amalzewita/Production-Line/README.md

# Project Information

- Project: `[Production Line for Product Sorting]`
- Authors: `[Amal Amr]`, `[Marawan Ashry]`, `[Malak Tarek]`
- Videos: [Link](https://drive.google.com/drive/u/0/folders/1szjnrMlwpyWx0n-irzwF31AYm2X0MozQ)

## Feedback & Contributions

Feedback is essential for the growth and improvement of this project. Please raise an issue in this repository for any bugs, suggestions, or improvements. Contributions via pull requests are also welcome!

## IMPORTANT NOTE
  A comprehensive PDF named `[Report]` detailing all pertinent information regarding the project is available.
