amalzewita/Production-Line/Report.pdf

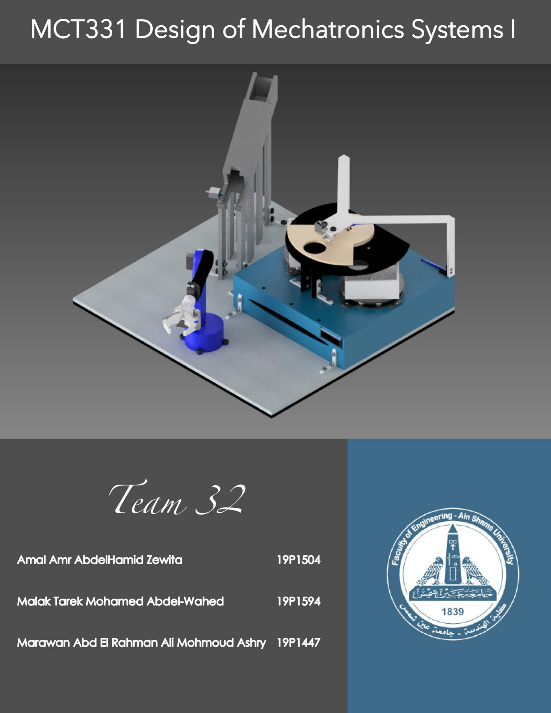
[picture p1: page 1]

1

AIN SHAMS UNIVERSITY
I-Credit Hours Engineering Programs (i.CHEP)
2 | Page

Contents

I-Credit Hours Engineering Programs (i.CHEP)

3 | Page

Table of figures

I-Credit Hours Engineering Programs (i.CHEP)

4 | Page

## ABSTRACT

A production line is a collection of coordinated procedures set up in a factory where parts are joined together to create finished goods or where raw materials are processed to create finished goods fit for consumption.
Usually, in order to make raw materials functional, such as metal ores, agricultural products like foodstuffs, or textile source plants like cotton and flax, a series of treatments is needed. The procedures for metal include crushing, smelting, and more refinement. For plants, the valuable material needs to be removed from the husks or other impurities before being processed for sale. In our project, we will design a production line consists of three main stations: Feeding, Sorting and packaging. By the help of a 3-DOF robotic arm which contains motors and sensors, we will be able to do the feeding station so that the robotic arm can take our product from the magazine and put it in the sorting-by material station. By placing the Inductive Proximity Switch- metal sensor, we could successfully sort our products by material by detect if the product is metal or not. In addition, our rotary-designed sorting mechanism will be able to do the packaging process which is the final station in our production line.
A lot of motors, sensors, gears, bearings.. will be used in our unique production lin. So that we will briefly discuss each station by its sensors and electrical and mechanical components and how they will work efficiently. Most common electrical and mechanical components used are:
- Servo motors
- IR sensor
- Inductive proximity sensor
- Arduino UNO
- Thrust Bearings
- L supports

By the end of this project, a well-organized production line will successfully be able to do the main three stations that we have already mentioned above by the help of a robotic arm with three degrees of freedom. So, we will now discus each station and how it works with the aid of the a well-organized and accurate sketches and images of the mechanical design by also showing the electrical parts and the reason for each usage.

I-Credit Hours Engineering Programs (i.CHEP)

5 | Page

## 1.0 INTRODUCTION

We should comprehend the stages involved in creating a mechatronic system on both a micro and macro cycle level for this project, as well as how to incorporate product design criteria like utilizing materials, utilizing a human-machine interface, and using modular components The successful testing of the product in accordance with each station's specifications, as well as the stations' integration and safety features, will all be evaluated.
The Design of Mechatronics Systems standard VDI 2206 must be followed while creating a production line. The manufacturing line's primary function is to handle cylindrical or cuboid-shaped products and sort them according to their shape or substance before packing each sorted product category into its own packaging.
So, Our project is a production line that consists of THREE main stations: Feeding, Sorting and packaging. By the aid of motors and sensors, we will be able to do the feeding station so that the robotic arm can take our product from the magazine and put it in the rotary sorting-by material station.
Multiple programs or threads can run simultaneously on the majority of operating systems. This is referred to as multitasking. At any given time, each processor core can only have one program running on it. The scheduler, a component of the operating system, selects which program to run at what time and creates the appearance of simultaneous operation by swiftly switching between each program.
A Real Time Operating System (RTOSscheduler )'s is created to offer a predictable (often referred to as deterministic) pattern of execution. Given that embedded systems, like the Arduino devices, frequently have real-time requirements, this is especially intriguing for embedded systems.

I-Credit Hours Engineering Programs (i.CHEP)

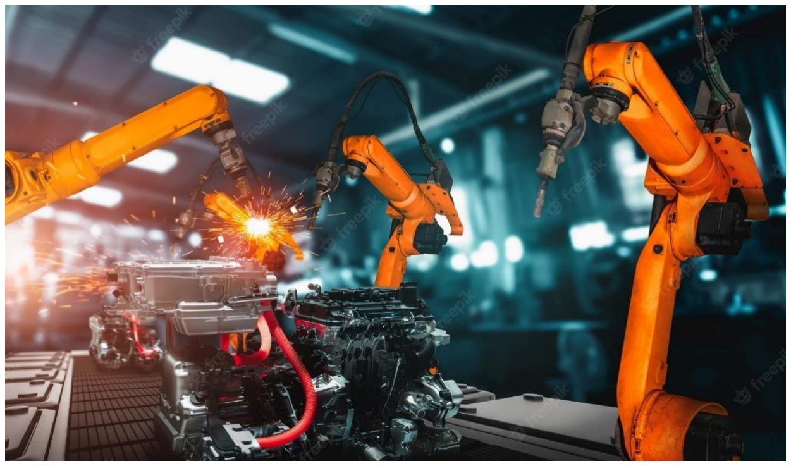
[picture p2: figure]

6 | Page

Traditional real-time schedulers, like the one included in FreeRTOS, accomplish determinism by letting the user give each execution thread a priority. The priority is then used by the scheduler to decide which thread of execution should be executed next. So, our software will be done by RTOS.

Figure 1:Production line

I-Credit Hours Engineering Programs (i.CHEP)

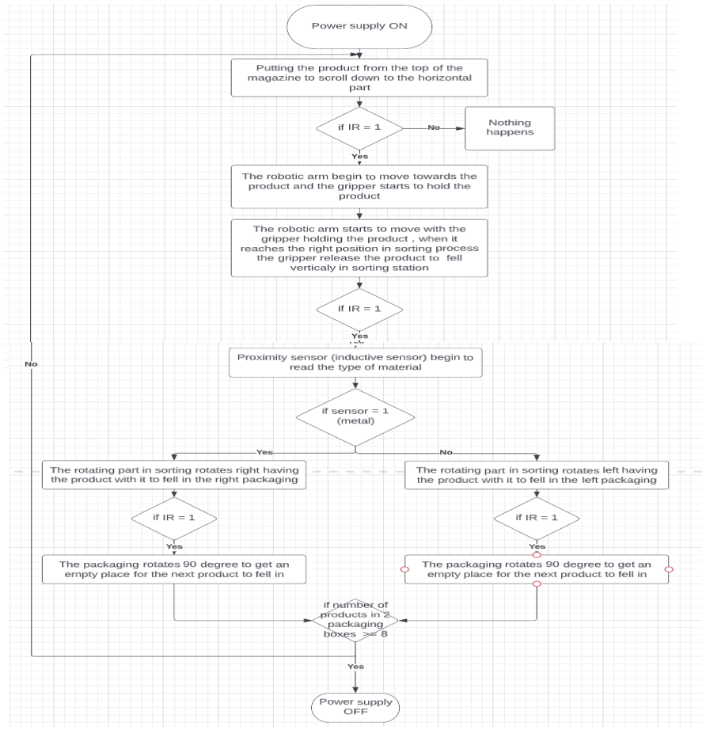
[picture p3: figure]

7 | Page

## 2.0 PRODUCT JOURNEY

Figure 2:Product journey flow chart

I-Credit Hours Engineering Programs (i.CHEP)

8 | Page

## 3.0 FEEDING STATION

### 3.1 Mechanical System

The magazine is our pure mechanical feeding station, It is an inclined box so that our cylindrical product will be able to roll over until the product is stop by a vertical surface and it is also our feeding station. Having an Infra-Red sensor at the end, this allows the robotic arm to pick the product through the opened-front legs and move it the sorting station. The magazine has three legs on each side which are fixed by grooves in both sides with the magazine and also the base. For more fixation, we added 4 L-supports using M8 bolts and nuts , 2 in each side to surely fix the magazine in base. Material: Wooden. Our magazine will be manufactured by a laser cutting machine. But the final part that stops the products will be made by 3D printing.
The IR sensor is placed at the end of the magazine which the horizontal part that the product will stay at until the robotic arm comes and grips it. A wooden box is designed by a laser cutting machine to cover the IR sensor. A M3 bolt is used to fix the IR sensor in the box and the box itself to the magazine.

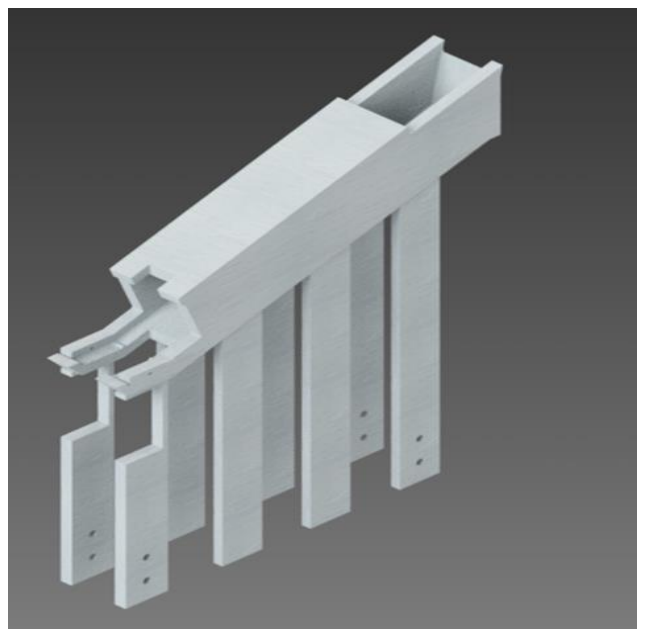
[picture p4: figure]

Figure 3:Feeding Station

I-Credit Hours Engineering Programs (i.CHEP)

9 | Page

## 4.0 SORTING STATION

### 4.1 Mechanical System

Our sorting-by material station is made of two plates and a thrust bearing. When the robotic arm takes the product from the magazine and then puts it into the sorting top plate hole, the proximity sensor reads the product’s material. Then, the plate moves either right or left by the help of a servo motor to drop the product into the packaging boxes via a hole in bottom plate. Due to the high weight on the sorting shaft, we add a thrust bearing to carry the axial load. We designed our thrust bearing to have a large diameter to support the top plate. We fixed the bottom thrust bearing plate into the bottom sorting plate with 4 M4 bolts. The supports that hold the fixed sorting plate are fixed by grooves in electrical box and L supports. Also, fixed with grooves and L supports also from the upper side with the fixed part of sorting and bolts from top and bottom. Material: Wooden. Our two plates of sorting mechanism were manufactured by a laser cutting machine.

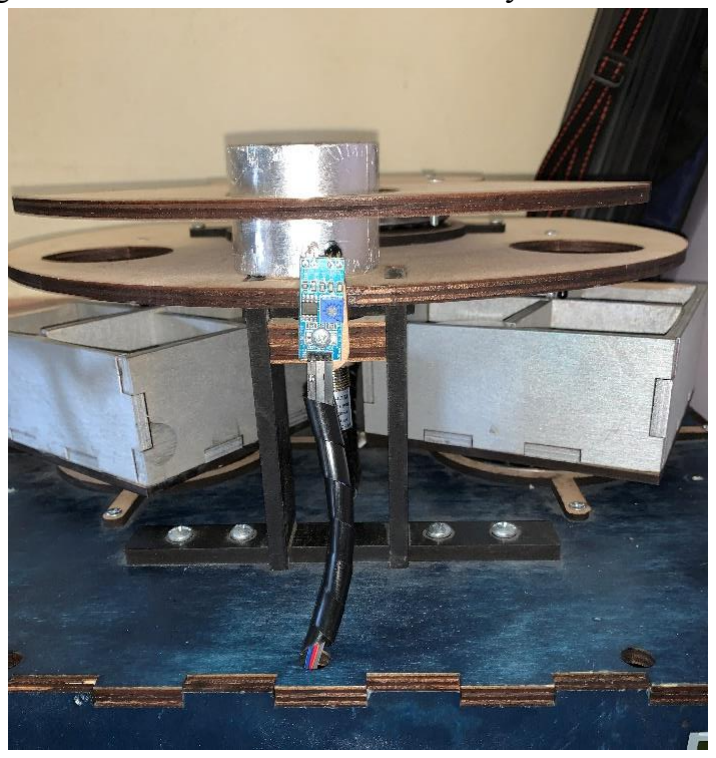
[picture p5: figure]

Figure 4: Sorting station

I-Credit Hours Engineering Programs (i.CHEP)

10 | Page

### 4.2 Actuator Sizing

Formula Sheet for motor

Tmotor = TR + Jtotalθ̈

Jtotal = 2 JL (effictive) + Jb (effictive) + Jp (effictive)
Where;
Jtotal total inertia,

JL (effictive) inertia load,

Jb (effictive) inertia belt,

Jp (effictive) inertia pully.

TR = TLoad + TFriction + TDamping
Where;
TR resisting torque
TLoad load torque,

TFriction friction torque,

TDamping damping torque.

Assuming TFriction = 0 / TDamping = 0

Jtotal = 2 JL (effictive) + Jb (effictive) + Jp (effictive)
mL = 0.227 kg / rp = 0.1775 m

JL (effictive) = 0.5mL(rp)

2
η | = 0.5 × 0.227 × (0.1775)²
1 | = 3.6 × 10⁻³kg. m²

Jtotal = 2(JL (effictive))

Jtotal = 7.15 × 10⁻³kg. m²

TR = TLoad
mL = 0.227 kg / rp = 0.1775 m

I-Credit Hours Engineering Programs (i.CHEP)

11 | Page

TLoad = FL rp

η = mL × g × rp
η = 0.227 × 9.81 × 0.1775
1
TR = 0.395 N. m
Assuming ta = 0.3 sec

θ = Π/4 rad

θ̈= ∂θ̇
∂t =

5Π
46 − 0
0.3 − 0
θ̈= ±1.138 rad/sec 2

Tmotor = TR + Jtotalθ̈

Assuming ta = td = 0.3 sec / tc = 2 sec
TR = 0.395 N. m/ Jtotal = 7.15 × 10⁻³kg. m²/ θ =̈ ± 1.138 rad/sec 2

Ta = TR + Jtotalθ̈= 0.395 + (1.138 × 7.15 × 10⁻³) = 0.403 N. m

Tc = TR = 0.395 N. m
Td = TR + Jtotalθ̈= 0.395 + (−1.138 × 7.15 × 10⁻³) = 0.386 N. m

Trms = √⁽⁽Ta)² × ta) + ((Tc)² × tc) + ((Td)² × td)

ta + tc + td

Trms = √⁽⁽⁰.403)² × 0.3) + ((0.395)² × 2) + ((0.386)² × 0.3)

2.6

Trms = 0.3949 N. m < Tmin = 0.9 N. m

(used motor rated torque after multiplying by safety factor )

I-Credit Hours Engineering Programs (i.CHEP)

12 | Page

## 5.0 PACKAGING STATION

### 5.1 Mechanical System

Our Packaging Mechanism is designed to be a box divided into 4 pieces that rotates 90° degrees with a servo motor whenever the IR sensor, planted into the electrical box beneath the packaging boxes, reads that there is a product that was dropped from the sorting station just to expose the empty space for the sorting to drop the new product. Each packaging box contains slots for the IR sensor. To fix the load exerted on the servo motor’s shaft, we used a thrust bearing to reduce the axial load on servo motor’s shaft. The servo motor’s shaft is inserted into horn to fix the servo motor into the packaging. The packaging IR sensors are nested in the fixed sorting plate and will be bended to read the products. Material: Wooden. Our packaging boxes will be manufactured by a laser cutting machine. And as every face has fingers so every face will be manufactured and then meshed together to do the box.

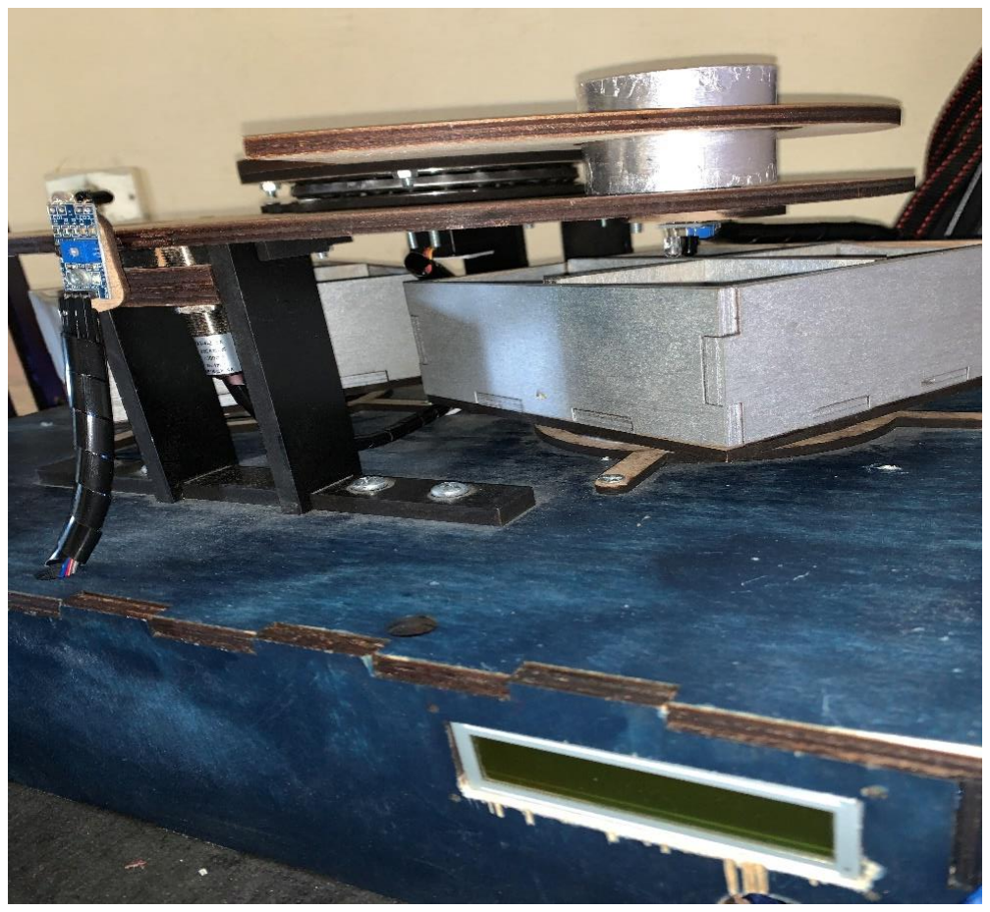
[picture p6: figure]

Figure 5:Packaging station

I-Credit Hours Engineering Programs (i.CHEP)

13 | Page

### 5.2 Actuator Sizing

- Motor of the package of metal products

Jtotal = 2 JL (effictive) + Jb (effictive) + Jp (effictive)
mL = 0.56 kg / rp = 0.0975 m

JL (effictive) = 0.5mL(rp)

2
η | = 0.5 × 0.56 × (0.0975)²
1 | = 2.6 × 10⁻³kg. m²

Jtotal = 2(JL (effictive))

Jtotal = 5.6 × 10⁻³kg. m²

TR = TLoad
mL = 0.56 kg / rp = 0.0975 m

TLoad = FL rp

η = mL × g × rp
η | = 0.56 × 9.81 × 0.0975
| 1
TR = 0.5356 N. m
Assuming ta = 0.3 sec

θ = Π/2 rad

θ̈= ∂θ̇
∂t =

5Π
18 − 0
0.3 − 0
θ̈= ±2.91 rad/sec 2

Tmotor = TR + Jtotalθ̈

Assuming ta = td = 0.3 sec / tc = 1.5 sec
TR = 0.5356 N. m/ Jtotal = 5.2 × 10⁻³kg. m²/ θ =̈ ± 2.91 rad/sec 2

Ta = TR + Jtotalθ̈= 0.5356 + (2.91 × 5.2 × 10⁻³) = 0.55 N. m

Tc = TR = 0.5356 N. m
Td = TR + Jtotalθ̈= 0.395 + (−1.138 × 7.15 × 10⁻³) = 0.52 N. m

I-Credit Hours Engineering Programs (i.CHEP)

14 | Page

Trms = √⁽⁽Ta)² × ta) + ((Tc)² × tc) + ((Td)² × td)

ta + tc + td

Trms = √⁽⁽⁰.55)² × 0.3) + ((0.5356)² × 1.5) + ((0.52)² × 0.3)

2.1

Trms = 0.5356 N. m < Tmin = 0.9 N. m

(used motor rated torque after multiplying by safety factor )

- Motor of the package of nonmetal products

Jtotal = 2 JL (effictive) + Jb (effictive) + Jp (effictive)
mL = 0.375 kg / rp = 0.0975 m

JL (effictive) = 0.5mL(rp)

2
η | = 0.5 × 0.375 × (0.0975)²
1 | = 1.78 × 10⁻³kg. m²

Jtotal = 2(JL (effictive))

Jtotal = 3.565 × 10⁻³kg. m²

TR = TLoad
mL = 0.375 kg / rp = 0.0975 m

TLoad = FL rp

η = mL × g × rp
η | = 0.375 × 9.81 × 0.0975
| 1
TR = 0.359 N. m
Assuming ta = 0.3 sec

θ = Π/2 rad

θ̈= ∂θ̇
∂t =
| 5Π 18 − 0
| 0.3 − 0
θ̈= ±2.91 rad/sec 2

Tmotor = TR + Jtotalθ̈

Assuming ta = td = 0.3 sec / tc = 1.5 sec

I-Credit Hours Engineering Programs (i.CHEP)

15 | Page

TR = 0.359 N. m/ Jtotal = 3.565 × 10⁻³kg. m²/ θ =̈ ± 2.91 rad/sec 2

Ta = TR + Jtotalθ̈= 0.359 + (2.91 × 3.565 × 10⁻³) = 0.364 N. m

Tc = TR = 0.359 N. m
Td = TR + Jtotalθ̈= 0.395 + (−1.138 × 7.15 × 10⁻³) = 0.354 N. m

Trms = √⁽⁽Ta)² × ta) + ((Tc)² × tc) + ((Td)² × td)

ta + tc + td

Trms = √⁽⁽⁰.364)² × 0.3) + ((0.359)² × 1.5) + ((0.354)² × 0.3)

2.1

Trms = 0.359 N. m < Tmin = 0.9 N. m (used motor rated torque after multiplying by safety factor )

I-Credit Hours Engineering Programs (i.CHEP)

16 | Page

## 6.0 ROBOTIC ARM

### 6.1 Mechanical System

Our robotic arm is 3-DOF structure. So, this robotic arm is able to grip the product from the magazine and put it which it will be able to pick the cylinders and move them to the sorting station. Each gear is fixed with a link and the link is fixed with a grip that’s fixed also with the base of the gripper. The grip is designed to be half circled from inside to hold the cylindrical product and make enough contact with its surface. ARM 1: It is a rotating arm connected to the servo motor in the base by a horn fixed with bolts. BASE: It is fixed to the base by 4 M3 bolts and where a servo motor is fixed inside to rotate Arm 1.
GRIPPER: A rotating gripper connected to Arm 2 by a servo motor with horn and bolts.
ARM 2: It is fixed to Arm 1 by a servo motor using a horn
with bolts. It is the initial position and it can rotates 180
degrees.

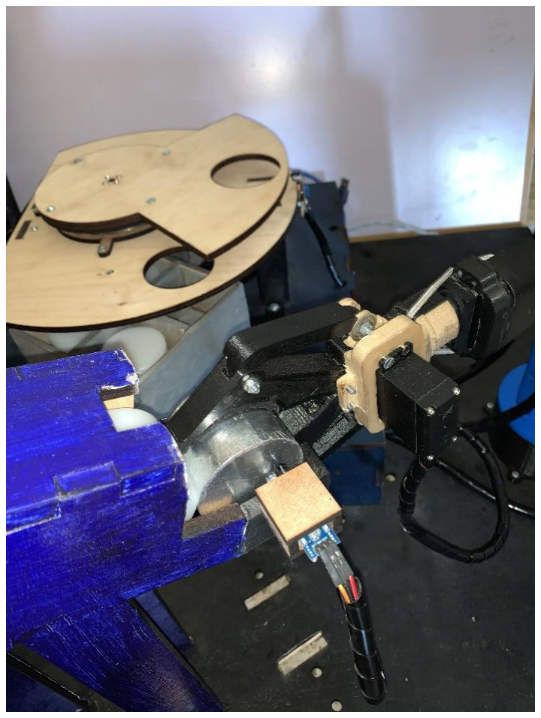
[picture p7: figure]

Material: PLA Our robotic arm will be manufactured by a 3D Printing machine. Figure 6:Robotic arm

I-Credit Hours Engineering Programs (i.CHEP)

17 | Page

### 6.2 Actuator Sizing

- Motor of the base of robotic arm

Jtotal = 2 JL (effictive) + Jb (effictive) + Jp (effictive)
mL = 0.955 kg / rp = 0.05 m

JL (effictive) = 0.5mL(rp)

2
η | = 0.5 × 0.955 × (0.05)²
1 | = 1.19 × 10⁻³ kg. m²

Jtotal = 2(1.19 × 10⁻³)

Jtotal = 2.38 × 10⁻³kg. m²

TR = TLoad
mL = 0.955 kg / rp = 0.05 m

TLoad = FL rp

η = mL × g × rp
η | = 0.955 × 9.81 × 0.05
| 1
TR = 0.468 N. m
Assuming ta = 0.4 sec

θ = 7Π/9 rad
θ̈= ∂θ̇ ∂t = | 35Π 198 − 0
| 0.4 − 0
θ̈= ±1.388 rad/sec 2

Tmotor = TR + Jtotalθ̈

Assuming ta = td = 0.4 sec / tc = 4 sec
TR = 0.468 N. m/ Jtotal = 2.38 × 10⁻³kg. m²/ θ =̈ ± 1.388 rad/sec 2

Ta = TR + Jtotalθ̈= 0.468 + (1.388 × 2.38 × 10⁻³) = 0.471 N. m

I-Credit Hours Engineering Programs (i.CHEP)

18 | Page

Tc = TR = 0.468 N. m
Td = TR + Jtotalθ̈= 0.468 + (−1.388 × 2.38 × 10⁻³) = 0.464 N. m

Trms = √⁽⁽Ta)² × ta) + ((Tc)² × tc) + ((Td)² × td)

ta + tc + td

Trms = √⁽⁽⁰.471)² × 0.4) + ((0.468)² × 4) + ((0.464)² × 0.4)

4.8

Trms = 0.4679 N. m < Tmin = 0.9 N. m

(used motor rated torque after multiplying by safety factor )

- Motor of the arm of robotic arm

Jtotal = 2 JL (effictive) + Jb (effictive) + Jp (effictive)
mL = 0.493 kg / rp = 0.31 m

JL (effictive) = 0.5mL(rp)

2
η | = 0.5 × 0.493 × (0.31)²
1 | = 0.024 kg. m²

Jtotal = 2(0.024)
Jtotal = 0.047kg. m²

TR = TLoad
mL = 0.493 kg / rp = 0.31 m

TLoad = FL rp

η = mL × g × rp
η = 0.493 × 9.81 × 0.31
1
TR = 1.5 N. m
Assuming ta = 0.3 sec

θ = 2Π/9 rad

θ̈= ∂θ̇
∂t =

10Π
81 − 0
0.3 − 0

I-Credit Hours Engineering Programs (i.CHEP)

19 | Page

θ̈= ±1.29 rad/sec 2

Tmotor = TR + Jtotalθ̈

Assuming ta = td = 0.3 sec / tc = 1.5 sec
TR = 1.5 N. m/ Jtotal = 0.047kg. m²/ θ =̈ ± 1.29 rad/sec 2

Ta = TR + Jtotalθ̈= 1.5 + (1.29 × 0.047) = 1.56 N. m

Tc = TR = 1.5 N. m
Td = TR + Jtotalθ̈= 1.5 + (−1.29 × 0.047) = 1.439 N. m

Trms = √⁽⁽Ta)² × ta) + ((Tc)² × tc) + ((Td)² × td)

| ta + tc + td

Trms = √⁽⁽¹.56)² × 0.3) + ((1.5)² × 1.5) + ((1.439)² × 0.3)

| 2.1

Trms = 1.51 N. m < Tmin = 2 N. m (used motor rated torque after multiplying by safety factor )

- Motor of the wrist of robotic arm

Jtotal = 2 JL (effictive) + Jb (effictive) + Jp (effictive)
mL = 0.288 kg / rp = 0.035 m

JL (effictive) = 0.5mL(rp)

2
η | = 0.5 × 0.288 × (0.035)²
1 | = 1.6 × 10⁻⁵kg. m²

Jtotal = 2(1.6 × 10⁻⁵)

Jtotal = 3.175 × 10⁻⁵kg. m²
3. Motor of the wrist of robotic arm

TR = TLoad
mL = 0.288 kg / rp = 0.035 m

I-Credit Hours Engineering Programs (i.CHEP)

20 | Page

TLoad = FL rp

η = mL × g × rp
η = 0.288 × 9.81 × 0.035
1
TR = 0.0988 N. m
Assuming ta = 0.3 sec

θ = Π/2 rad

θ̈= ∂θ̇
∂t =

5Π
23 − 0
0.3 − 0
θ̈= ±2.277 rad/sec 2

Tmotor = TR + Jtotalθ̈

Assuming ta = td = 0.3 sec / tc = 2 sec

TR = 0.0988 N. m/ Jtotal = 3.175 × 10⁻⁵kg. m²/ θ =̈ ± 2.277 rad/sec 2

Ta = TR + Jtotalθ̈= 0.0988 + (2.277 × 3.175 × 10⁻⁵) = 0.0989 N. m

Tc = TR = 0.0988 N. m

Td = TR + Jtotalθ̈= 0.0988 + (−2.277 × 3.175 × 10⁻⁵) = 0.0987 N. m

Trms = √⁽⁽Ta)² × ta) + ((Tc)² × tc) + ((Td)² × td)

ta + tc + td

Trms = √⁽⁽⁰.0989)² × 0.3) + ((0.0988)² × 2) + ((0.0987)² × 0.3)

2.6

Trms = 0.098 N. m < Tmin = 0.3 N. m (used motor rated torque after multiplying by safety factor )

I-Credit Hours Engineering Programs (i.CHEP)

21 | Page
- Motor of the gripper of robotic arm

Jtotal = 2 JL (effictive) + Jb (effictive) + Jp (effictive)
mL = 0.174 kg / rp = 0.0155 m

JL (effictive) = 0.5mL(rp)

2

η

+

0.5mg(rg)

2

η

= 0.5 × 0.174 × (0.0155)²
1 | +

0.5 × 0.0.0068 × (0.0155)²
1 | = 2.49 × 10⁻⁸kg. m²

Jtotal = 2(JL (effictive))

Jtotal = 4.984 × 10⁻⁸kg. m²
4. Motor of the gripper of robotic arm

TR = TLoad
mL = 0.174 kg / rp = 0.0155 m

TLoad = FL rp

η = mL × g × rp
η = 0.174 × 9.81 × 0.0155
1
TR = 0.026 N. m
Assuming ta = 0.3 sec

θ = 7Π/18 rad

θ̈= ∂θ̇
∂t =

35Π
162 − 0
0.3 − 0
θ̈= ±2.26 rad/sec 2

Tmotor = TR + Jtotalθ̈

Assuming ta = td = 0.3 sec / tc = 1.5 sec

TR = 0.026 N. m/ Jtotal = 4.984 × 10⁻⁸kg. m²/ θ =̈ ± 2.26 rad/sec 2

I-Credit Hours Engineering Programs (i.CHEP)

22 | Page

Ta = TR + Jtotalθ̈= 0.026 + (2.26 × 4.984 × 10⁻⁸) = 0.0261 N. m

Tc = TR = 0.026 N. m
Td = TR + Jtotalθ̈= 0.026 + (−2.26 × 4.984 × 10⁻⁸) = 0.0259 N. m

Trms = √⁽⁽Ta)² × ta) + ((Tc)² × tc) + ((Td)² × td)

ta + tc + td

Trms = √⁽⁽⁰.0261)² × 0.3) + ((0.026)² × 1.5) + ((0.0259)² × 0.3)

2.1

Trms = 0.026 N. m < Tmin = 0.3 N. m (used motor rated torque after multiplying by safety factor )

I-Credit Hours Engineering Programs (i.CHEP)

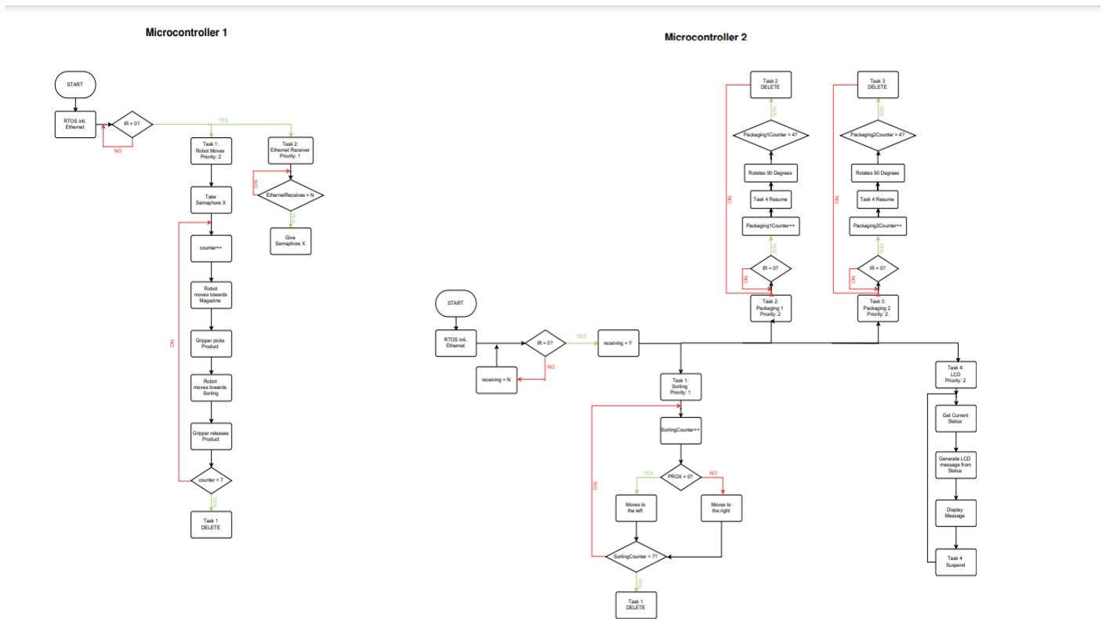
[picture p8: figure]

23 | Page

## 7.0 SOFTWARE FLOW CHART

A well organized and accurate flowchart of the whole project software using RTOS, showing our two microcontrollers and how we connect them by the ethernet commun

I-Credit Hours Engineering Programs (i.CHEP)

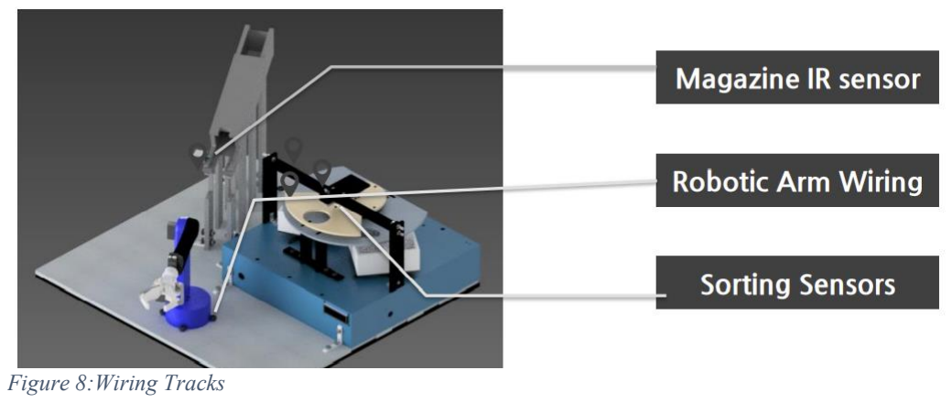
[picture p9: figure]
Figure 8:Wiring Tracks

24 | Page

## 8.0 CIRCUITS AND WIRING

### 8.1 Control Box

Our wooden control box with 400x100x400 mm that contains all the electronics. All the wires coming out from each part is going through that control box holes and slot. In addition, for more professional and cleaner look we made holes in the control box bottom to pass the wires beneath the base and on witch is fixed our sorting and packaging stations.

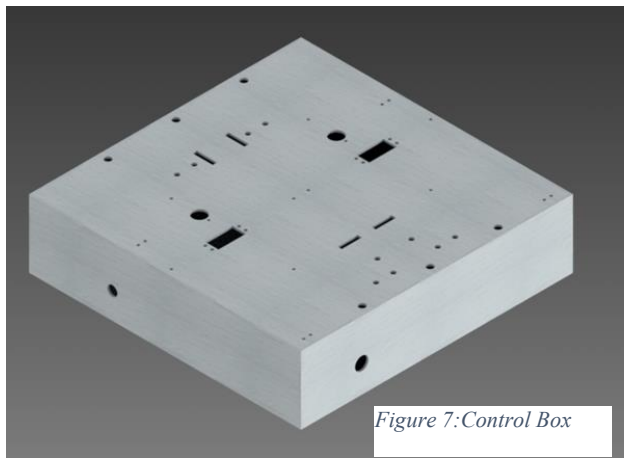
[picture p10: figure]
Figure 7:Control Box

### 8.2 Wiring Tracks

All jumpers are well wired so that they will be assembled in the control box.

I-Credit Hours Engineering Programs (i.CHEP)

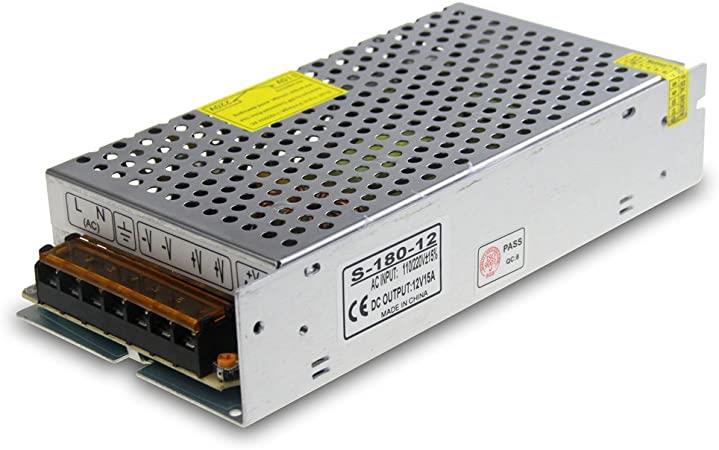
[picture p11: figure]
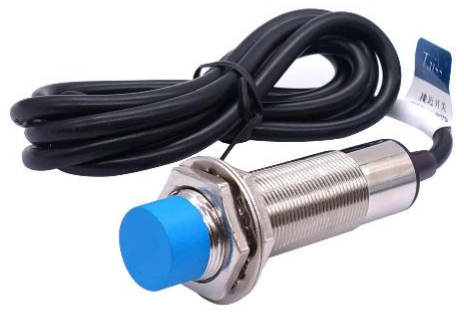
[picture p12: figure]

25 | Page

### 8.3 Electronic Components

- 12 volts-15A Power Supply.
- Two Arduino UNO
- Two Bucks Step down module to get a 6 Volts output to power all servo motors.
- Seven Servo motors ( 4: Robotic arm, 2 for each packaging box, 1 for sorting).
- Four Infra-Red sensors ( 1: agazine, 1 for sorting, 2 for each packaging box).
- One Proximity inductive sensor to detect metal products.
- LCD
- I2C Module to reduce the lacd pins.
- Router for the ethernet communication.
- PCBs

Figure 9:Power Supply

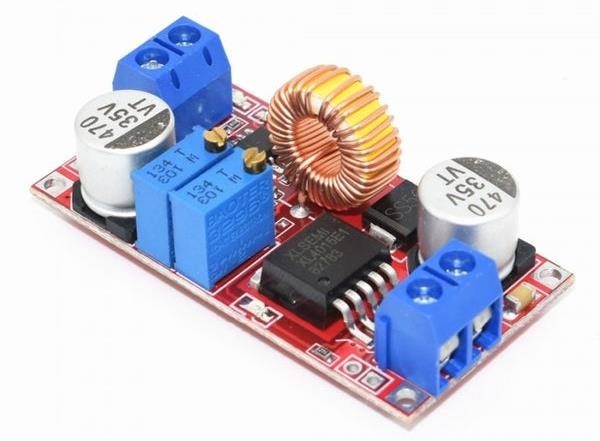
[picture p13: figure]

Figure 10:Buck module

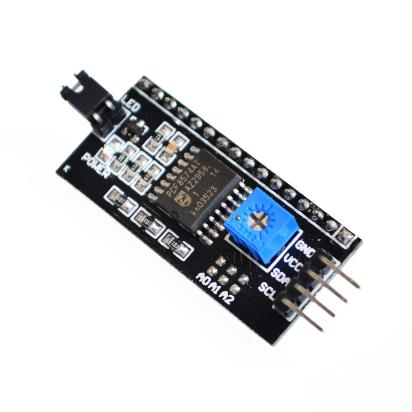
[picture p14: figure]

Figure 12:Proximity sensor | Figure 11:I2C module

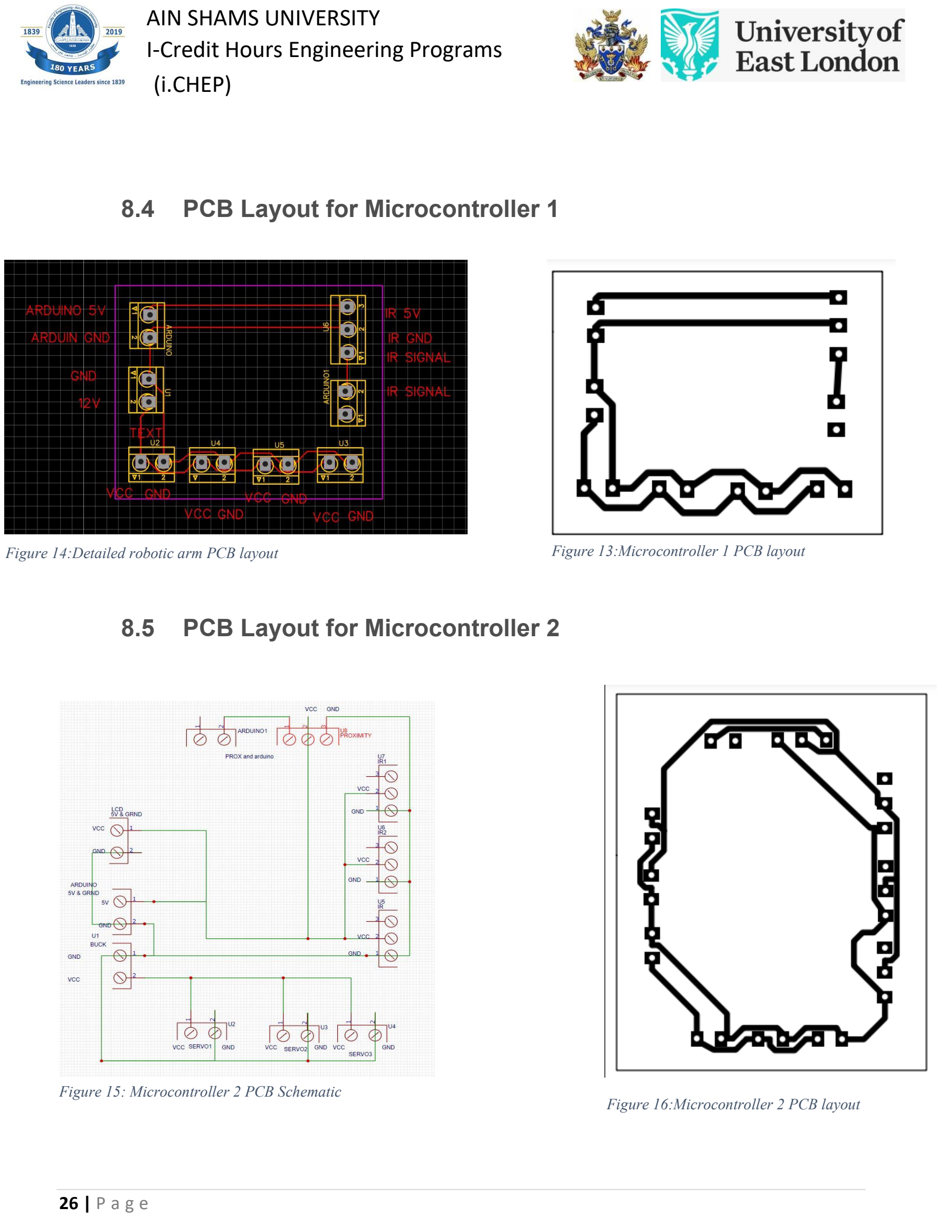
[picture p15: page 26]

I-Credit Hours Engineering Programs (i.CHEP)

26 | Page

### 8.4 PCB Layout for Microcontroller 1

### 8.5 PCB Layout for Microcontroller 2

Figure 14:Detailed robotic arm PCB layout | Figure 13:Microcontroller 1 PCB layout

Figure 16:Microcontroller 2 PCB layout Figure 15: Microcontroller 2 PCB Schematic

I-Credit Hours Engineering Programs (i.CHEP)

27 | Page

## 9.0 ETHERNET COMMUNICATION

Using common Ethernet protocols in an industrial setting is known as industrial Ethernet (IE). Since IE systems make use of the physical layer that is already present in the majority of contexts and is easily expandable, there is less of a need to create additional networks. A new level of freedom in application configuration and system design is made possible by industrial Ethernet communication. We can build networks that are more effective and versatile thanks to Ethernet connectivity. There are Ethernet networks everywhere.

### 9.1 Sender

#include <Arduino_FreeRTOS.h> #include "LiquidCrystal_I2C.h" #include <EtherCard.h>

#include "semphr.h"

#include <Servo.h>

const int n = 1; //if n = 0 textToSend is send (Metal) if n = 1 textToSend2 is send (Non Metal) /* Addresses */
static byte mymac[] = { 0x1A,0x2B,0x3C,0x4D,0x5E,0x6F }; // mac address
static byte myip[] = { 192, 168, 1, 2 }; // ethernet interface ip address
static byte gwip[] = { 192, 168, 1, 1 }; // gateway ip address Must be same in both Sender and reciver
static byte mask[] = { 255, 255, 255, 0 }; // subnet mask
static byte dstIp[] = { 192, 168, 1, 3 }; // destination ip-address (reciver ip address)
// ports

I-Credit Hours Engineering Programs (i.CHEP)

28 | Page

const int dstPort PROGMEM = 1234; const int srcPort PROGMEM = 4321;

/* Data to send via Ethernet */
char noProduct[] = "NO"; // NO text that will be send char Product[] = "YES"; // YES text that will be send

/* Buffer and timer */
byte Ethernet::buffer[700];
static uint32_t timer; // dummy incrementor that'll later be used for delays

// Calling LCD PINS
LiquidCrystal_I2C lcd(0x3F,16,2);

// for if condition in LCD
boolean state = true;

// calling task functions
static void SortingTask(void* parameters); static void PackagingTask(void* parameters); static void LCDTask(void* parameters);

// Global Variables
// Packaging 1
int i = 0;
// Packaging 2
int x = 0;

I-Credit Hours Engineering Programs (i.CHEP)

29 | Page

// Servo calling
Servo SortingServo;
Servo Packaging1Servo;
Servo Packaging2Servo;

// defining servos here cause they're classes int pinServo_Sorting = 3;
int pinServo_Packaging1 = 5;
int pinServo_Packaging2 = 6;

// defining the sorting proximity sensor int pinPROX = A0;

// defining IR sensors
int pinIR_Sorting = 2; // Sorting IR
int pinIR_Packaging1 = 4; // Packaging 1 IR int pinIR_Packaging2 = 7; // Packaging 2 IR

// initialization values of each sensor
int valIR_Packaging1 = 0;
int valIR_Packaging2 = 0;
int valIR_Sorting = 0;
int valPROX = 0;

// counters
int counterSorting = 0;
int counterPackaging = 0;
int counterPackaging1_LCD = 0;

I-Credit Hours Engineering Programs (i.CHEP)

30 | Page

int counterPackaging2_LCD = 0;

//create a binary semaphore SemaphoreHandle_t xBinarySemaphore; SemaphoreHandle_t xBinary1Semaphore;

// Task handeling
TaskHandle_t SortingTask_handle; TaskHandle_t PackagingTask_handle; TaskHandle_t LCDTask_handle;

/* Ethernet peripheral initialization function */ void initializeEthernet()
{
// Begin Ethernet communication
if (ether.begin(sizeof Ethernet::buffer, mymac, 10) == 0) // if using Mega use value 53 if using uno use value 10
{ Serial.println("Failed to access Ethernet controller");
return;}

// Setup static IP address
ether.staticSetup(myip, gwip, 0, mask);

// Log configuration
Serial.println(F("\n[Sender]")); ether.printIp("IP: ", ether.myip); ether.printIp("GW: ", ether.gwip); }

I-Credit Hours Engineering Programs (i.CHEP)

31 | Page

void setup() {
// Initializing Serial Monitor Serial.begin(57600);
// Initializing LCD
lcd.init();
lcd.backlight();
// Initialize Ethernet
initializeEthernet();

// For packaging 1
lcd.setCursor(0,0);
lcd.print("Metal Count: "); // For packaging 2
lcd.setCursor(0,1);
lcd.print("Artelon Count: ");

// Creating task semaphore
xBinarySemaphore = xSemaphoreCreateBinary(); // sorting to packaging xBinary1Semaphore = xSemaphoreCreateBinary(); // packaging to LCD

// Set the classes
SortingServo.attach(pinServo_Sorting); Packaging1Servo.attach(pinServo_Packaging1); Packaging2Servo.attach(pinServo_Packaging2);

// Set the digital pins
pinMode(pinPROX, INPUT);

I-Credit Hours Engineering Programs (i.CHEP)

32 | Page

pinMode(pinIR_Sorting, INPUT); pinMode(pinIR_Packaging1, INPUT); pinMode(pinIR_Packaging2, INPUT);

// Create tasks and assign their priorities
xTaskCreate(SortingTask, "Sorting_Task", 200, NULL, 1, &SortingTask_handle); xTaskCreate(PackagingTask, "Packaging_Task", 200, NULL, 2, &PackagingTask_handle);
xTaskCreate(LCDTask, | "LCD_Task", | 100, NULL, 3, &LCDTask_handle);

// starts tasks with its priorities
vTaskStartScheduler();

} // END of setup function

void loop() { } // END of loop function

// function that's responsible for product sorting static void SortingTask(void* parameters) { while(1) {
valIR_Sorting = digitalRead(pinIR_Sorting); valPROX = digitalRead(pinPROX);

// ethernet sending
for(int i = 0; i <= 3; i++){
if (millis() > timer) {
timer = millis() + 100;
// testing funtion if changed the global variable from the top from zero or one as to identify metal or non metal this should be your function

I-Credit Hours Engineering Programs (i.CHEP)

33 | Page

if(valIR_Sorting == 1)
{ether.sendUdp(noProduct,sizeof(noProduct),srcPort,dstIp,dstPort );} else if(valIR_Sorting == 0) {ether.sendUdp(Product,sizeof(Product),srcPort,dstIp,dstPort );}
}
}

// sorting process
if(valIR_Sorting == 0 && valPROX == 1) { counterSorting++;
for (int i = 94; i >= 45; i--) { SortingServo.write(i);
vTaskDelay(10/portTICK_PERIOD_MS); }
vTaskDelay(1000/portTICK_PERIOD_MS); } // Metal Sorting
else if(valIR_Sorting == 0 && valPROX == 0) { counterSorting++;
for (int i = 94; i <= 150; i++) { SortingServo.write(i);
vTaskDelay(10/portTICK_PERIOD_MS); }
vTaskDelay(1000/portTICK_PERIOD_MS); } // Artelon Sorting
else {
SortingServo.write(94);
vTaskDelay(1000/portTICK_PERIOD_MS);

I-Credit Hours Engineering Programs (i.CHEP)

34 | Page

} // no product to be found

SortingServo.write(94);
vTaskDelay(1000/portTICK_PERIOD_MS);

// gives semaphore to the packaging xSemaphoreGive(xBinarySemaphore);

// deleting task after 8 products if(counterSorting > 7) {
vTaskDelete(SortingTask_handle); }
}
} // END of SortingTask function

// function that's responsible for Packaging 1 static void PackagingTask(void* parameters) {
while(1) {
// takes semaphore from the sorting xSemaphoreTake(xBinarySemaphore, portMAX_DELAY); valIR_Packaging1 = digitalRead(pinIR_Packaging1); valIR_Packaging2 = digitalRead(pinIR_Packaging2);

if(valIR_Packaging1 == 0) {
counterPackaging++;
Packaging2Servo.write(0);
vTaskDelay(273/portTICK_PERIOD_MS); Packaging2Servo.write(90);

I-Credit Hours Engineering Programs (i.CHEP)

35 | Page

vTaskDelay(273/portTICK_PERIOD_MS); }
if(valIR_Packaging2 == 0) { counterPackaging++;
Packaging1Servo.write(0);
vTaskDelay(273/portTICK_PERIOD_MS); Packaging1Servo.write(90); vTaskDelay(273/portTICK_PERIOD_MS); }

// gives semaphore to the LCD //xSemaphoreGive(xBinary1Semaphore);

if(counterPackaging > 7) { vTaskDelete(PackagingTask_handle); }
}
} // END of SortingTask function

// function that's responsible for LCD static void LCDTask (void* parameters) {
while(1) {
// takes semaphore from the packaging //xSemaphoreTake(xBinary1Semaphore, portMAX_DELAY); valIR_Packaging1 = digitalRead(pinIR_Packaging1); valIR_Packaging2 = digitalRead(pinIR_Packaging2);

if (valIR_Packaging1 == 0 && state == true){

I-Credit Hours Engineering Programs (i.CHEP)

36 | Page

counterPackaging1_LCD++;
state = false;
lcd.setCursor(15,0);
lcd.print(counterPackaging1_LCD); vTaskDelay(1000/portTICK_PERIOD_MS);
}
else if (valIR_Packaging2 == 0 && state == true){ counterPackaging2_LCD++;
state = false;
lcd.setCursor(15,1);
lcd.print(counterPackaging2_LCD); vTaskDelay(1000/portTICK_PERIOD_MS);
}

if (valIR_Packaging1 == 1 || valIR_Packaging2 == 1 ) { state = true;
vTaskDelay(1000/portTICK_PERIOD_MS);
}

if(counterPackaging1_LCD > 3 && counterPackaging2_LCD > 3 ) { vTaskDelete(LCDTask_handle);
}
}
} // END of LCDTask function

I-Credit Hours Engineering Programs (i.CHEP)

37 | Page

### 9.2 Receiver

#include <Arduino_FreeRTOS.h> #include <IPAddress.h>

#include <EtherCard.h>

#include <Servo.h>

// Global variables
// base
int i = 0;
int j = 0;
int k = 0;
// arm
int x = 0;
int y = 0;
int z = 0;
// wrist
int w = 0;
int r = 0;
// gripper
int g = 0;

I-Credit Hours Engineering Programs (i.CHEP)

38 | Page

// Servo calling
Servo BaseServo;
Servo ArmServo;
Servo WristServo;
Servo GripperServo;

// defining servos here cause they're classes int pinServo_Base = 3;
int pinServo_Arm = 5;
int pinServo_Wrist = 6;
int pinServo_Gripper = 9;

// defining IR sensors
int pinIR_Magazine = 8; // Sorting IR

// initialization values of each sensor int valIR_Magazine = 0;
//int valIR_Sorting = 0;

// counters
int Counter = 0;

// Task handeling
TaskHandle_t RoboticArmTask_handle = NULL;

const int n;
/* Addresses */

I-Credit Hours Engineering Programs (i.CHEP)

39 | Page

static byte mymac[] = { 0x70,0x69,0x69,0x2D,0x30,0x31 }; // mac address static byte myip[] = { 192, 168, 1, 3 }; // ethernet interface ip address static byte gwip[] = { 192, 168, 1, 1 }; // gateway ip address
static byte mask[] = { 255, 255, 255, 0 };// subnet mask
// ports
const int dstPort PROGMEM = 1234;

/* Buffer */
byte Ethernet::buffer[700];

void initializeEthernet()
{
// Begin Ethernet communication
if (ether.begin(sizeof Ethernet::buffer, mymac, 10) == 0) // if using Mega use value 53 if using uno use value 10
{ Serial.println("Failed to access Ethernet controller");
return;}

// Setup static IP address
ether.staticSetup(myip, gwip, 0, mask);

// Log configuration
Serial.println(F("\n[Receiver]")); ether.printIp("IP: ", ether.myip); ether.printIp("GW: ", ether.gwip);
}

/* callback that prints received packets to the serial port */

I-Credit Hours Engineering Programs (i.CHEP)

40 | Page

void udpSerialPrint(uint16_t dest_port, uint8_t src_ip[IP_LEN], uint16_t src_port, const char *data, uint16_t len){
IPAddress src(src_ip[0],src_ip[1],src_ip[2],src_ip[3]);

Serial.println(data); // print the data send ); if(data=='NO') // dummy condition just for testing {int n =0;
Serial.println(n);
}}

void setup() {
// Initializing Serial Monitor Serial.begin(9600);

// Initialize Ethernet
initializeEthernet();

//register udpSerialPrint() to destination port (callback function) ether.udpServerListenOnPort(&udpSerialPrint, dstPort);

// Set the classes
BaseServo.attach(pinServo_Base); ArmServo.attach(pinServo_Arm); WristServo.attach(pinServo_Wrist); GripperServo.attach(pinServo_Gripper);

// Set the digital pins
pinMode(pinIR_Magazine, INPUT);

I-Credit Hours Engineering Programs (i.CHEP)

41 | Page

// Create tasks and assign theor priorities
// Create the Idle task for when there is no task in operation
// Idle task has the highest priority
xTaskCreate(RoboticArmTask, | "Robotic Arm Task", | 1000, NULL, 1,
&RoboticArmTask_handle);

} // END of setup function

void loop() { } // END of loop function

// function that's responsible for taking products to sorting static void RoboticArmTask(void* parameters) { while(1) {
int p = 0;
// receive packets, get ready for callbacks ether.packetLoop(ether.packetReceive()); valIR_Magazine = digitalRead(pinIR_Magazine); if(valIR_Magazine == 1) {
Counter++;
// between magazine and sorting
for (i = j; i <= 120; i++) { BaseServo.write(i);
vTaskDelay(60/portTICK_PERIOD_MS); }
vTaskDelay(1000/portTICK_PERIOD_MS);

I-Credit Hours Engineering Programs (i.CHEP)

42 | Page

// arm gonna move down for the magazine for (x = y; x <= 20; x++) { ArmServo.write(x);
vTaskDelay(20/portTICK_PERIOD_MS); }
vTaskDelay(1000/portTICK_PERIOD_MS); // base centering into the magazine
for (j = i; j <= 133; j++) {
BaseServo.write(j);
vTaskDelay(60/portTICK_PERIOD_MS); }
vTaskDelay(1000/portTICK_PERIOD_MS); i = 0;
// gripper grips
for (g = p; g <= 48.5; g++) { GripperServo.write(g);
vTaskDelay(20/portTICK_PERIOD_MS); }
vTaskDelay(1000/portTICK_PERIOD_MS); // arm gonna move up to pick the product for (y = x; y >= 0; y--) {
ArmServo.write(y);
vTaskDelay(20/portTICK_PERIOD_MS); }
vTaskDelay(1000/portTICK_PERIOD_MS); // wrist rotating 90
for (w = r; w <= 90; w++) { WristServo.write(w);

I-Credit Hours Engineering Programs (i.CHEP)

43 | Page

vTaskDelay(20/portTICK_PERIOD_MS); }
vTaskDelay(1000/portTICK_PERIOD_MS); // base going to sorting
for (k = j; k >= 60; k--) {
BaseServo.write(k);
vTaskDelay(60/portTICK_PERIOD_MS); }
vTaskDelay(1000/portTICK_PERIOD_MS); j = 0;
// arm moving down again for sorting
for (x = 0; x <= 15; x++) { ArmServo.write(x);
vTaskDelay(20/portTICK_PERIOD_MS); }
vTaskDelay(3000/portTICK_PERIOD_MS); // gripper releases
for ( p = g; p >= 0; p--) { GripperServo.write(p);
vTaskDelay(20/portTICK_PERIOD_MS); }
vTaskDelay(3000/portTICK_PERIOD_MS); WristServo.write(0);
} // Taking product to sorting
else { // everything sets to zero
for (int a = k; a >= 0; a--) { k--;
BaseServo.write(a);

I-Credit Hours Engineering Programs (i.CHEP)

44 | Page

vTaskDelay(60/portTICK_PERIOD_MS); }
for (int a = y; a >= 0; a--) {
y--;
ArmServo.write(a);
vTaskDelay(20/portTICK_PERIOD_MS); }
for (int a = w; a >= 0; a--) {
w--;
WristServo.write(a);

vTaskDelay(20/portTICK_PERIOD_MS); }
} // no product to be found

BaseServo.write(0);
ArmServo.write(0);
WristServo.write(0);
GripperServo.write(0);

if(Counter > 7) {
vTaskDelete(NULL);
}
}
} // END of Base Task function

I-Credit Hours Engineering Programs (i.CHEP)

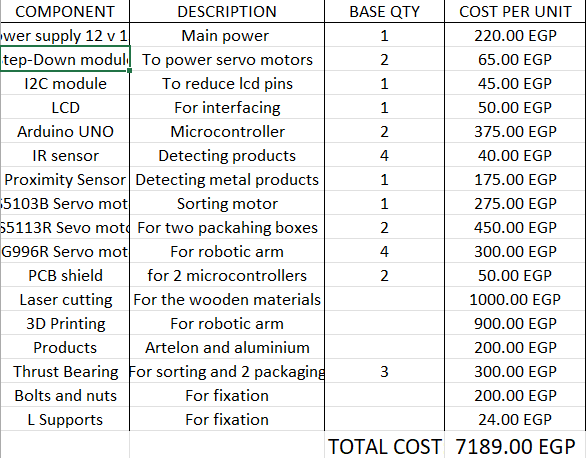
[picture p16: figure]

45 | Page

## 10.0 BILL OF MATERIALS

Figure 17:Bill of materials
